korsh624/husky/design/dxf/3.dxf

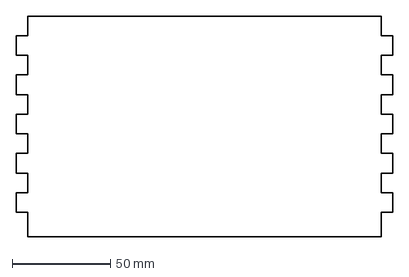
[picture p11: CAD file, 2022-07-31]
design/dxf/3.dxf
192.0 x 112.5 mm
