korsh624/husky/design/ковш/низ2.dxf

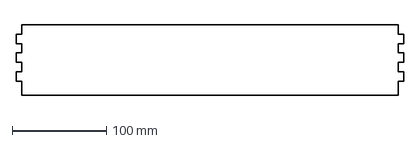
[picture p12: CAD file, 2022-07-31]
design/ковш/низ2.dxf
412.0 x 75.0 mm
