korsh624/husky/design/ковш/Новая папка/барабан6.dxf

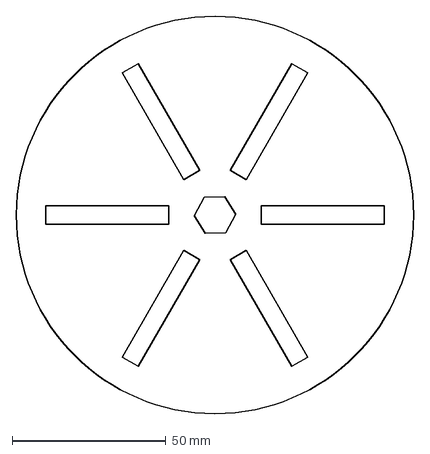
[picture p13: CAD file, 2022-07-31]
design/ковш/Новая папка/барабан6.dxf
129.0 x 129.0 mm
