korsh624/husky/design/dxf/2.dxf

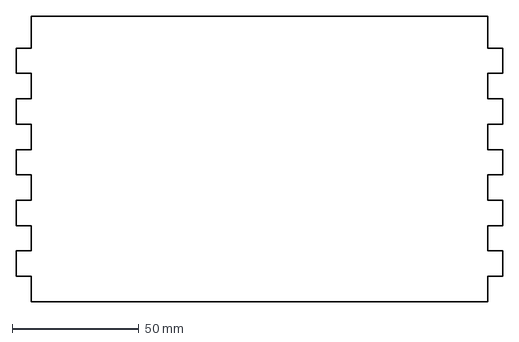
[picture p14: CAD file, 2022-07-31]
design/dxf/2.dxf
192.0 x 112.5 mm
