korsh624/husky/design/ковш/mot37.stl

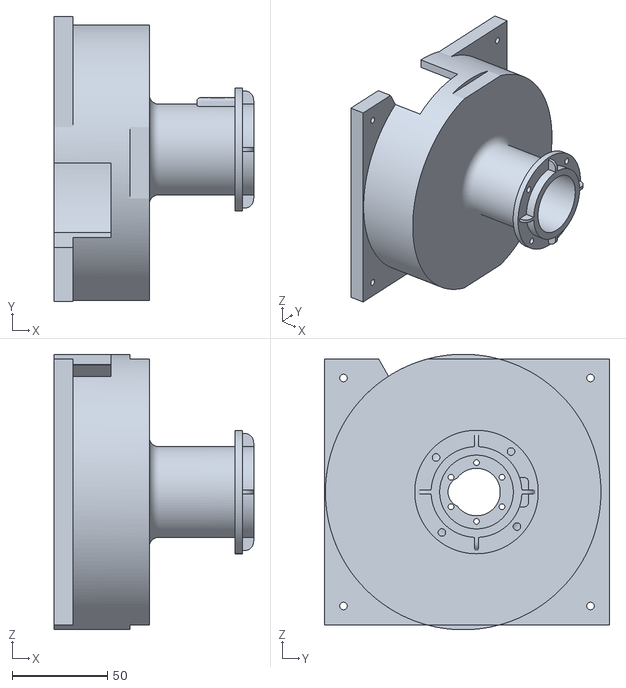
[picture p15: CAD file, 2022-07-31]
design/ковш/mot37.stl
105.0 x 150.0 x 145.0
