korsh624/husky/design/ковш/Новая папка/shelob.stl

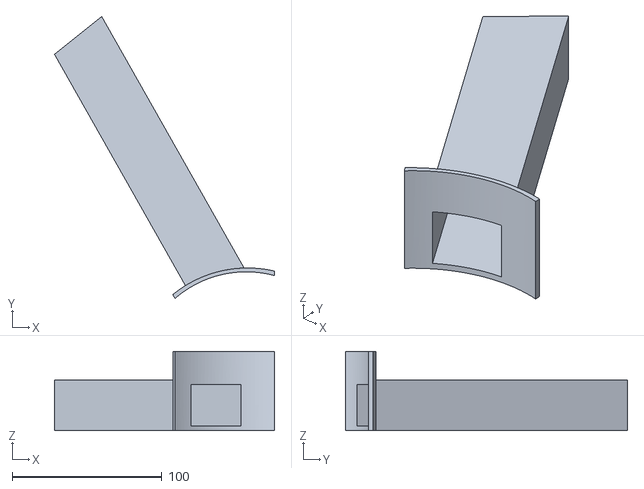
[picture p16: CAD file, 2022-07-31]
design/ковш/Новая папка/shelob.stl
147.0 x 188.4 x 53.0
