korsh624/husky/design/dxf/маленькое дно 1.dxf

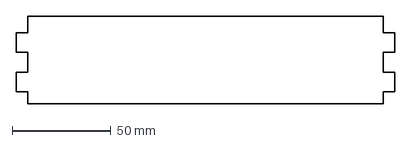
[picture p17: CAD file, 2022-07-31]
design/dxf/маленькое дно 1.dxf
192.0 x 44.2 mm
