korsh624/husky/design/ковш/Новая папка/верх.dxf

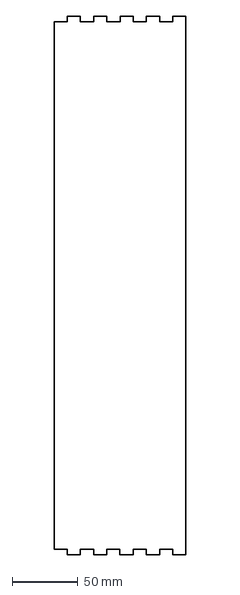
[picture p18: CAD file, 2022-07-31]
design/ковш/Новая папка/верх.dxf
100.0 x 408.0 mm
