korsh624/husky/design/ковш/середина.dxf

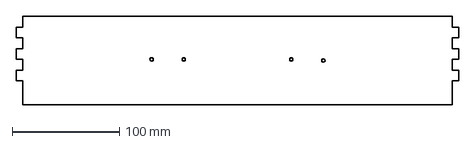
[picture p19: CAD file, 2022-07-31]
design/ковш/середина.dxf
412.0 x 82.0 mm
