korsh624/husky/design/dxf/1.dxf

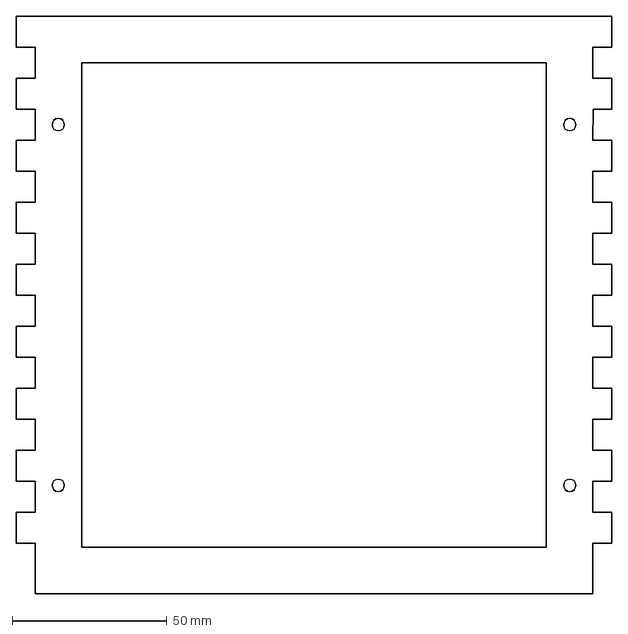
[picture p20: CAD file, 2022-07-31]
design/dxf/1.dxf
192.0 x 186.3 mm
