korsh624/husky/design/ковш/верх2.dxf

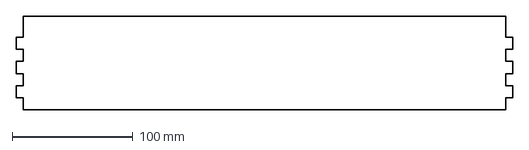
[picture p21: CAD file, 2022-07-31]
design/ковш/верх2.dxf
412.0 x 77.5 mm
