korsh624/husky/design/ковш/Новая папка/зад.dxf

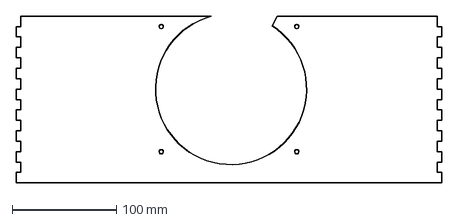
[picture p22: CAD file, 2022-07-31]
design/ковш/Новая папка/зад.dxf
408.0 x 160.0 mm
