korsh624/husky/design/dxf/top.dxf

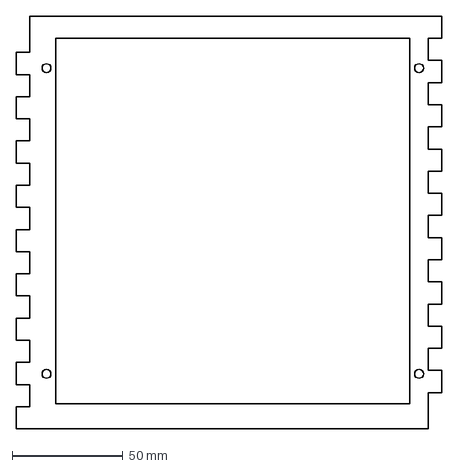
[picture p23: CAD file, 2022-07-31]
design/dxf/top.dxf
192.0 x 186.3 mm
