korsh624/husky/design/ковш/pprofil.stl

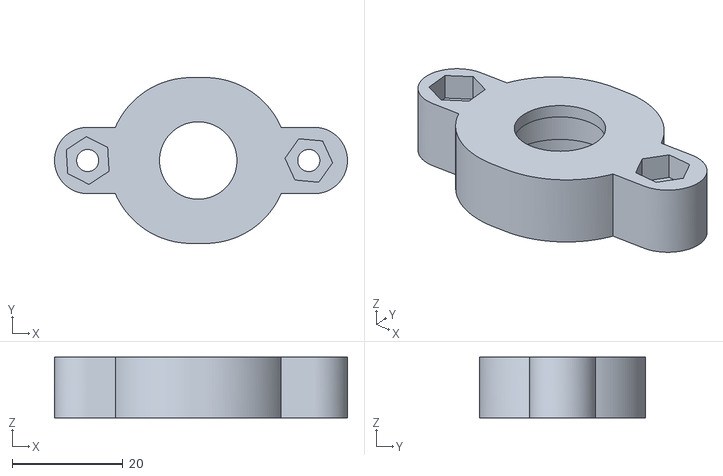
[picture p24: CAD file, 2022-07-31]
design/ковш/pprofil.stl
53.0 x 30.0 x 11.0
