korsh624/husky/design/ковш/Новая папка/бок 2.dxf

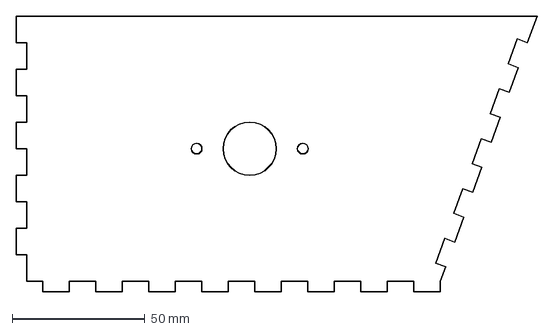
[picture p25: CAD file, 2022-07-31]
design/ковш/Новая папка/бок 2.dxf
196.4 x 104.0 mm
