korsh624/husky/design/dxf/4.dxf

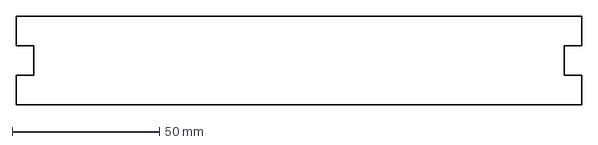
[picture p26: CAD file, 2022-07-31]
design/dxf/4.dxf
192.0 x 30.0 mm
