korsh624/husky/design/ковш/верх.dxf

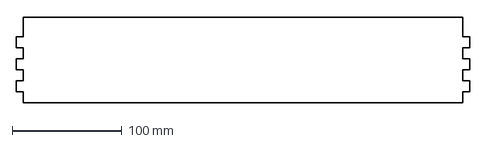
[picture p27: CAD file, 2022-07-31]
design/ковш/верх.dxf
412.0 x 77.5 mm
