korsh624/husky/design/ковш/Новая папка/лепесток.dxf

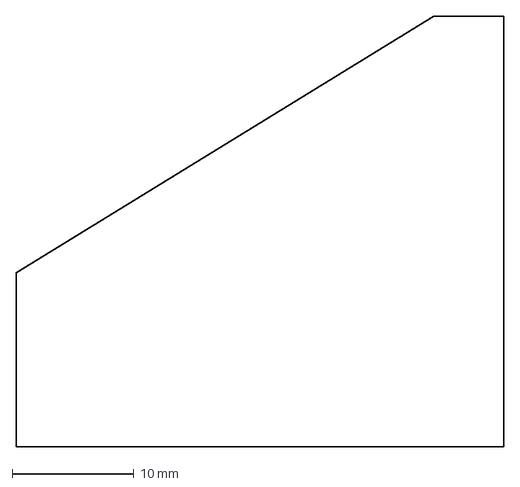
[picture p28: CAD file, 2022-07-31]
design/ковш/Новая папка/лепесток.dxf
40.0 x 35.3 mm
