korsh624/husky/design/dxf/5.dxf

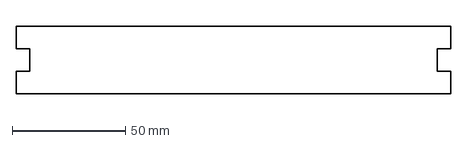
[picture p29: CAD file, 2022-07-31]
design/dxf/5.dxf
192.0 x 30.0 mm
