korsh624/husky/design/ковш/низ.dxf

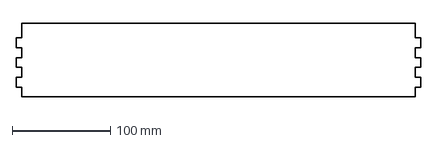
[picture p30: CAD file, 2022-07-31]
design/ковш/низ.dxf
412.0 x 75.0 mm
