korsh624/husky/design/ковш/Новая папка/неиз.dxf

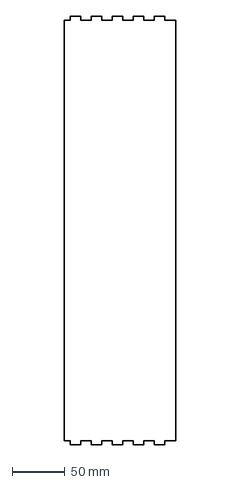
[picture p31: CAD file, 2022-07-31]
design/ковш/Новая папка/неиз.dxf
106.4 x 408.0 mm
