korsh624/husky/design/dxf/дно.dxf

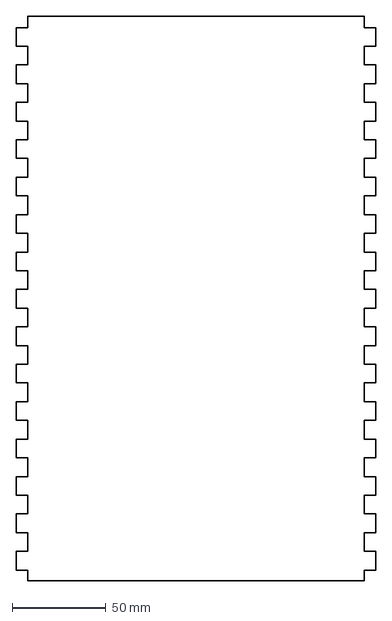
[picture p32: CAD file, 2022-07-31]
design/dxf/дно.dxf
192.0 x 301.7 mm
