korsh624/husky/design/ковш/боковая.dxf

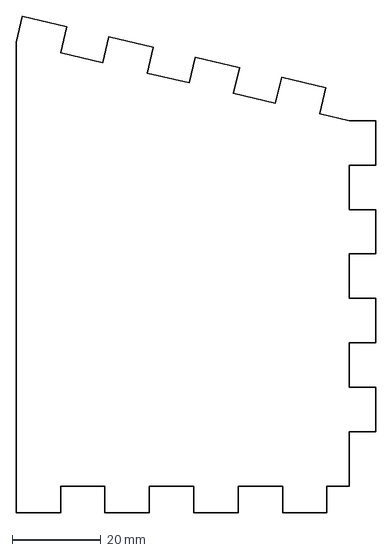
[picture p33: CAD file, 2022-07-31]
design/ковш/боковая.dxf
81.0 x 111.8 mm
