korsh624/husky/design/ковш/Новая папка/бок1.dxf

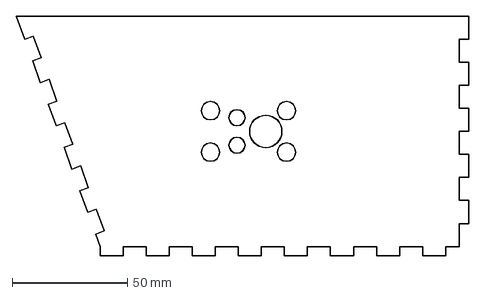
[picture p34: CAD file, 2022-07-31]
design/ковш/Новая папка/бок1.dxf
196.4 x 104.0 mm
