korsh624/husky/design/dxf/маленькое дно 2.dxf

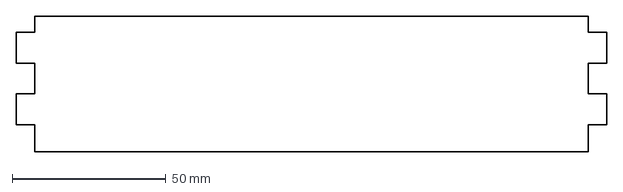
[picture p35: CAD file, 2022-07-31]
design/dxf/маленькое дно 2.dxf
192.0 x 44.1 mm
