korsh624/husky/design/dxf/боковина.dxf

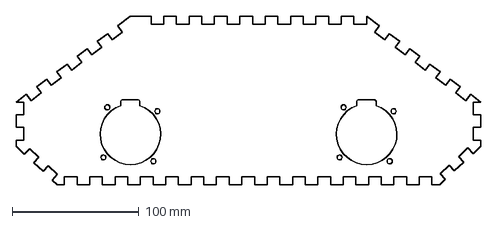
[picture p36: CAD file, 2022-07-31]
design/dxf/боковина.dxf
366.3 x 132.7 mm
