korsh624/husky/(list of files, cad)

Other CAD files:
design/Сборка2-1.dwg
design/OldVersions/mot37.0007.ipt
design/OldVersions/Двигатель.0002.ipt
design/OldVersions/Моторный блок.0002.iam
design/OldVersions/Сборка2-1.0001.dwg
design/OldVersions/Сборка2.0003.iam
design/OldVersions/боковина.0001.ipt
design/OldVersions/верх.0001.ipt
design/OldVersions/дно.0001.ipt
design/mot37.ipt
design/Двигатель.ipt
design/Деталь7.ipt
design/Диск.0001.ipt
design/Моторный блок.iam
design/Сборка2.iam
design/Шина.0002.ipt
design/боковина.ipt
design/верх.ipt
design/дно.ipt
design/задняя.ipt
design/ковш/OldVersions/Stenka.0004.ipt
design/ковш/OldVersions/kowsh.0007.iam
design/ковш/OldVersions/mot37.0011.ipt
design/ковш/OldVersions/Барабан.0003.ipt
design/ковш/OldVersions/Двигатель червячный.0003.ipt
design/ковш/OldVersions/Лепесток.0002.ipt
design/ковш/OldVersions/боковушка.0002.ipt
design/ковш/OldVersions/боковушка_двиг.0003.ipt
design/ковш/OldVersions/задняя стенка.0002.ipt
design/ковш/Stenka.ipt
design/ковш/kowsh.iam
design/ковш/mot37.ipt
design/ковш/Барабан.ipt
design/ковш/Двигатель червячный.ipt
design/ковш/Двигатель.ipt
design/ковш/Лепесток.ipt
design/ковш/Новая папка/желоб.ipt
design/ковш/боковушка.ipt
design/ковш/боковушка_двиг.ipt
design/ковш/верх.ipt
design/ковш/задняя стенка.ipt
design/ковш/низ.ipt
design/ковш/ппрофиль.ipt
design/маленькое дно1.ipt
design/мальенькое дно 2.ipt
design/передавина.ipt
design/полуверх 2.ipt
design/полуверх.ipt
